jyan6400/MTRX3700-Major-Project/sim/data/lab_photo.jpg

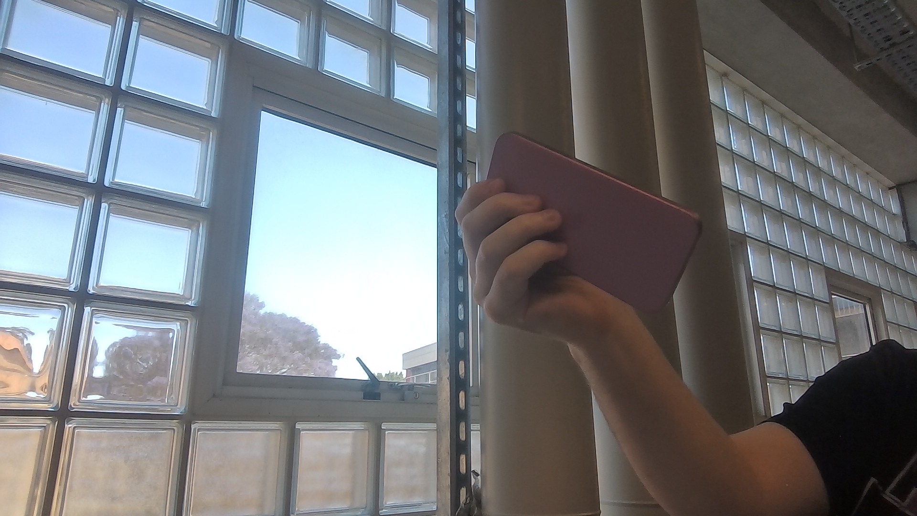
sim/data/lab_photo.jpg
