jyan6400/MTRX3700-Major-Project/(commit log)

2026-10-26 feat(v2): three-colour LED mask, run filter and tri-LED detector (M2)
    - red_mask: now a wrapper over led_colour_mask. Port list unchanged and
    default output bit-identical to V1 (exhaustive equivalence bench);
    TARGET_COLOUR parameter selects red/green/blue onto is_red.
    - led_colour_mask: combinational dominant-channel classifier for RGB565,
    at most one colour per pixel, zero latency.
    - colour_run_filter: horizontal run-length speckle filter, zero latency,
    centroid bias compensated.
    - tri_led_detect: mask -> filter -> 3 x led_centroid (V2 gated) for the
    three-bay demo. Not wired into the top yet (needs wider vision CDC).
    - New benches: red_mask_v1_equiv_tb, led_colour_mask_tb,
    tri_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
2026-10-27 fix(v2): reconcile camera and vision regression tests
2026-10-27 feat(v2): integrate sonar filtering and forward-motion safety
2026-10-28 Add FrameGrab vision and temporal LED detection experiments
2026-10-28 Integrate V3 camera recovery and restore V2 regression compatibility
2026-10-28 Integrate V3 reverse motion supervisor and UART safety tests
2026-10-29 V3-D10A: verify full-resolution CCL latency and frame recovery
2026-10-29 V3-D10B Stage 1: integrate temporal pixel detection and sequential CCL
2026-10-29 V3-D10B Stage 2: validate camera PCLK perception pipeline
2026-10-29 V3-D10B Stage 3: validate coherent PCLK to CLOCK_50 result CDC
2026-10-29 V3-D10C Stage 1: validate camera-to-50MHz perception integration
2026-10-29 V3-D10C Stage 5D: achieve full FPGA timing closure
2026-10-31 V3 Stage 6A-6B: verify CDC mailbox and synchroniser timing
